jancvek/arduino/pic/esp8258(esp-M3)_pinout.JPG

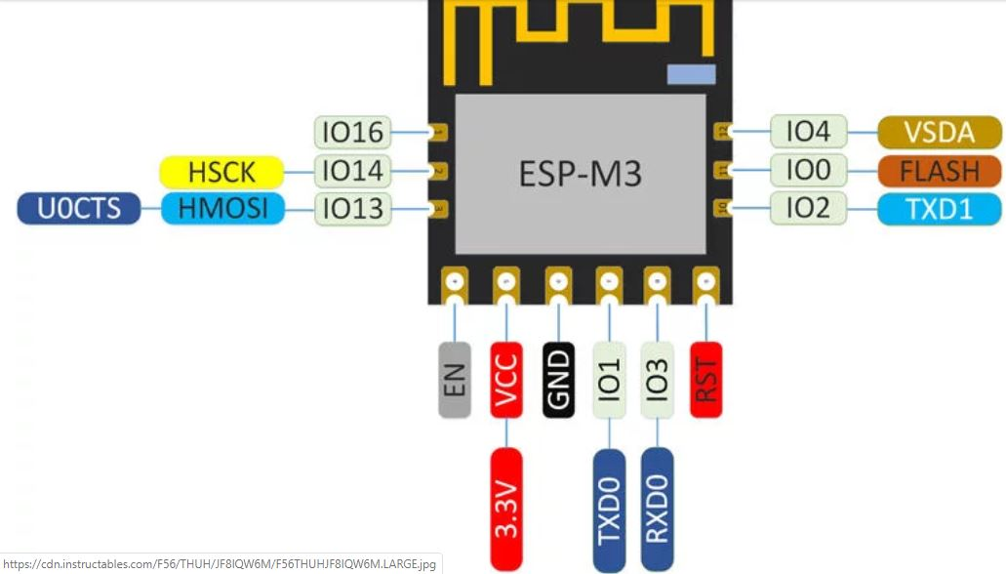
pic/esp8258(esp-M3)_pinout.JPG
