jancvek/arduino/pic/esp8266(barebone)_pinout.JPG

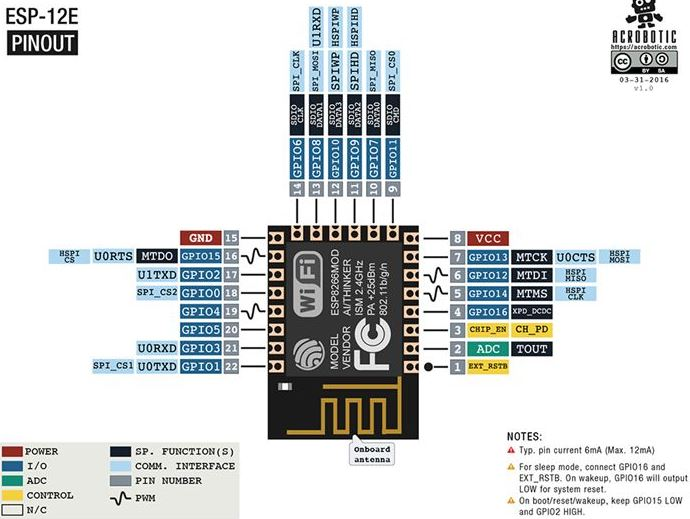
pic/esp8266(barebone)_pinout.JPG
