jancvek/arduino/pic/esp8266(nodeMCU)_pinout.JPG

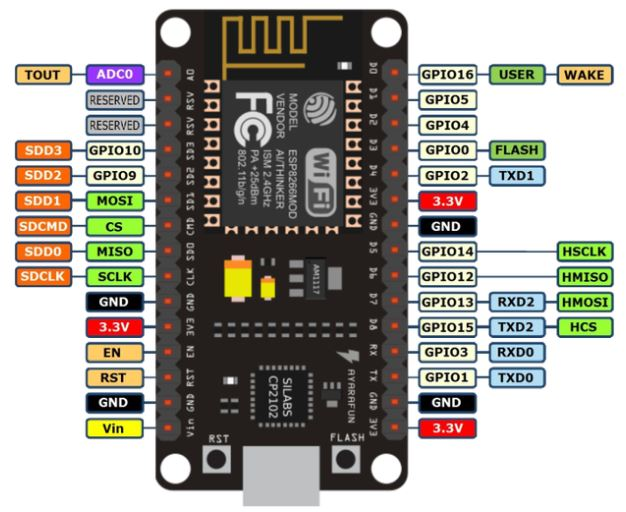
pic/esp8266(nodeMCU)_pinout.JPG
