jancvek/arduino/(commit log)

2018-12-17 Change raspberry pi ip addres
2019-03-11 add pic and test sensor code
2019-03-14 Updated code and added plate plane
    [ESP8266_PLATE.xlsx]
2019-03-14 updated plate plan
    [ESP8266_PLATE.xlsx]
